gregdavill/d20-hardware/enclosure/r0.1/stl/SPECS.md

# 3d printing specs

Design printed and validated with Spapeways

Material: Multi Jet Fusion Plastic (PA12)
Colour: Black
Cost: ~$80 USD
