gregdavill/d20-hardware/docs/repository-open-graph-template.png

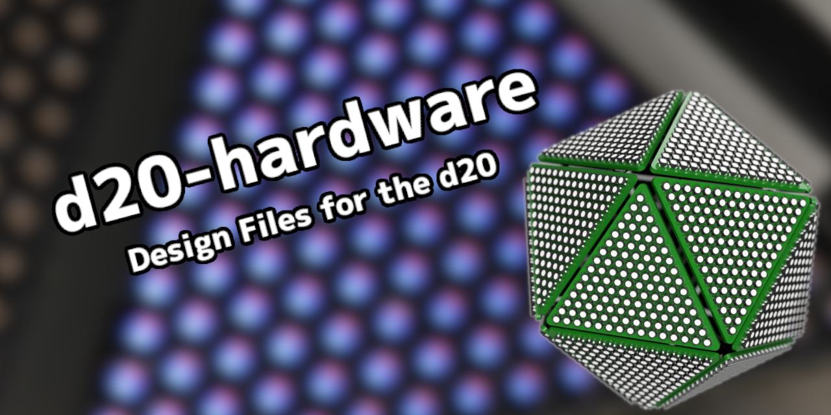
docs/repository-open-graph-template.png
