gregdavill/d20-hardware/pcb/controller/d20_r0.1/Production/d20_r0.1-Front.png

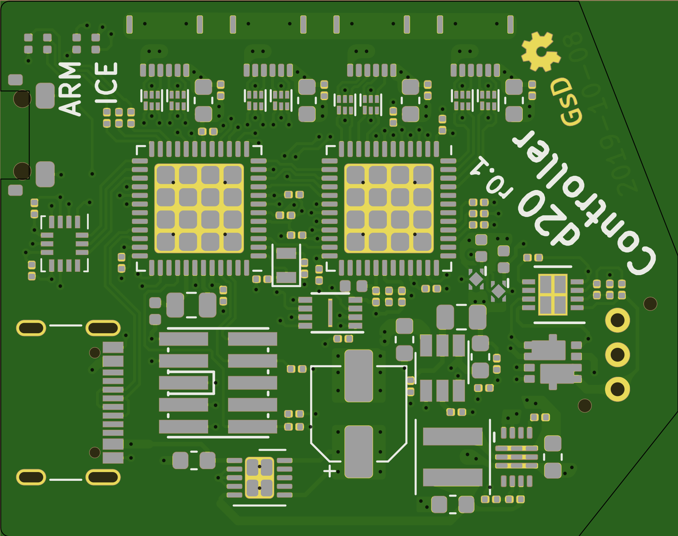
pcb/controller/d20_r0.1/Production/d20_r0.1-Front.png
