gregdavill/d20-hardware/pcb/led-panels/d20_tri_r0.1/Production/tri_4x1_r0.1-Front.png

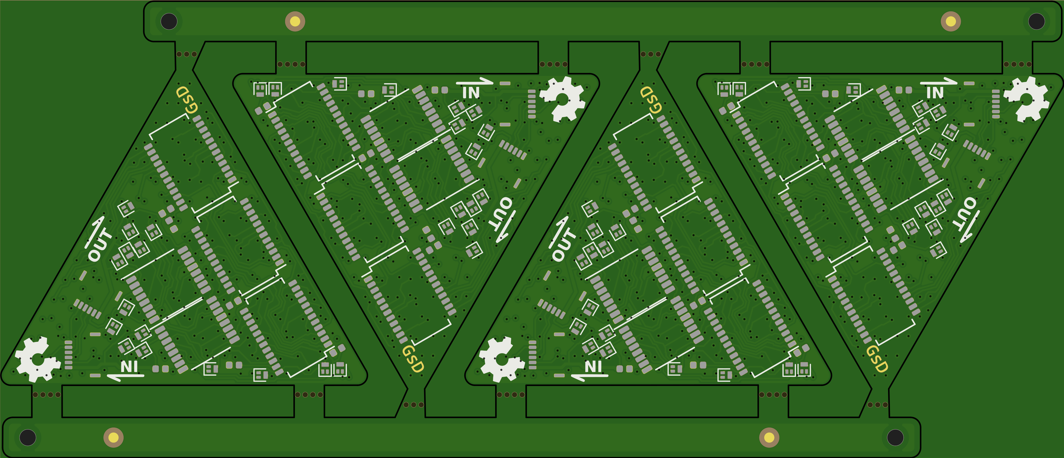
pcb/led-panels/d20_tri_r0.1/Production/tri_4x1_r0.1-Front.png
