gregdavill/d20-hardware/pcb/led-panels/d20_tri_r0.2/Production/d20_tri_r0.2_4x1-Front.png

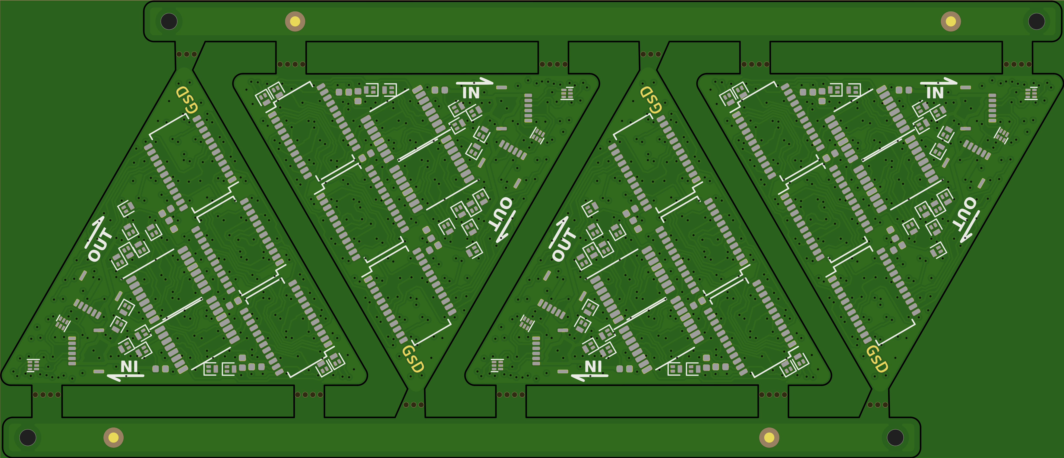
pcb/led-panels/d20_tri_r0.2/Production/d20_tri_r0.2_4x1-Front.png
