gregdavill/d20-hardware/pcb/led-panels/d20_tri_r0.2/ref/ref.png

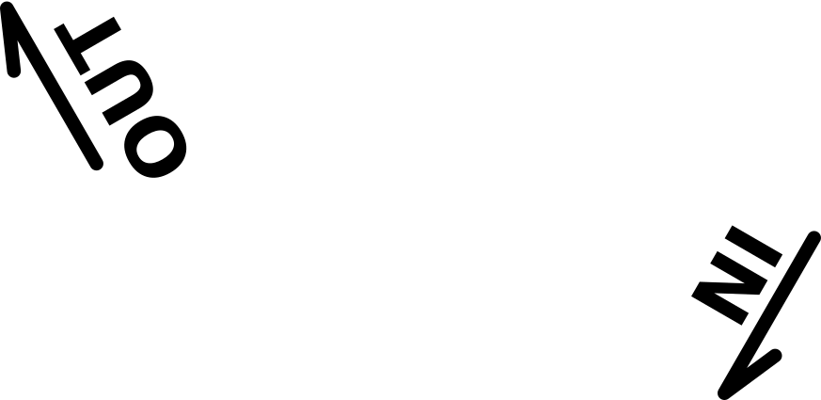
pcb/led-panels/d20_tri_r0.2/ref/ref.png
