gregdavill/d20-hardware/pcb/led-panels/d20_tri_r0.3/Production/d20_tri_r0.3_4x1-Front.png

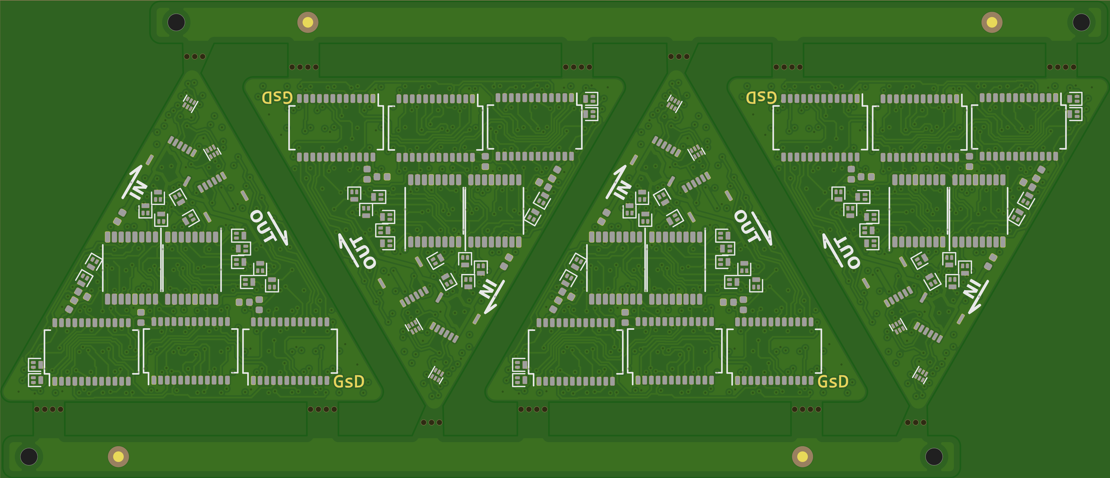
pcb/led-panels/d20_tri_r0.3/Production/d20_tri_r0.3_4x1-Front.png
