gregdavill/d20-hardware/enclosure/r0.1/d20_enclosure_r0.1.step

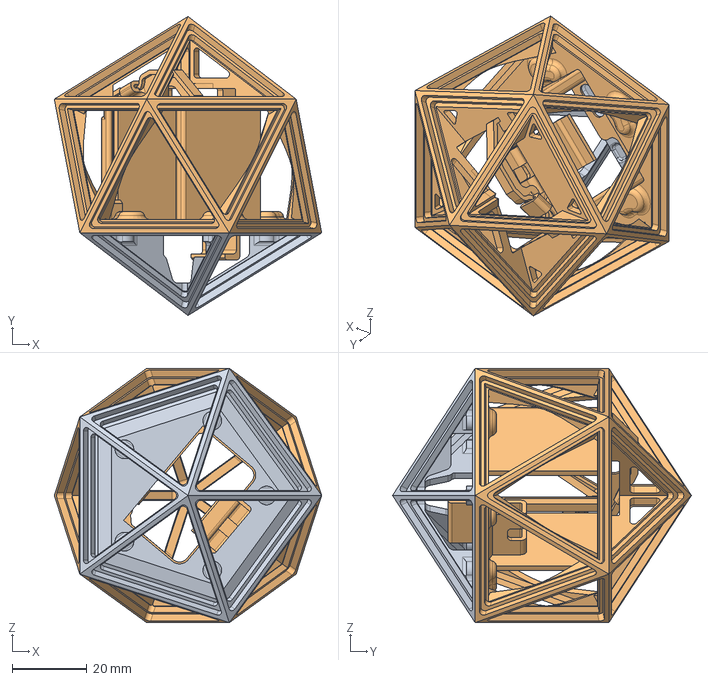
[picture p16: CAD file, 2021-06-30]
enclosure/r0.1/d20_enclosure_r0.1.step
71.5 x 79.9 x 68.0 mm
enclosure: top
enclosure: bottom
