gregdavill/d20-hardware/enclosure/r0.1/stl/d20_enclosure_r0.1_001.stl

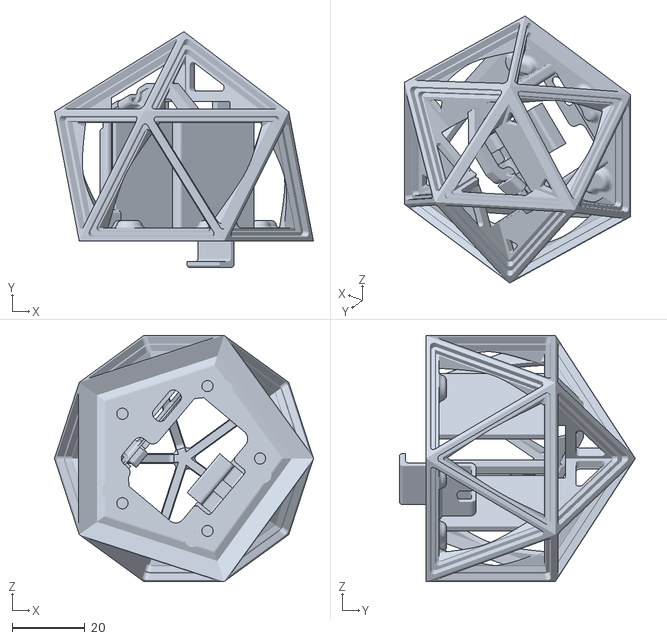
[picture p17: CAD file, 2021-03-29]
enclosure/r0.1/stl/d20_enclosure_r0.1_001.stl
71.5 x 65.0 x 68.0
