gregdavill/d20-hardware/enclosure/r0.1/stl/d20_enclosure_r0.1_002.stl

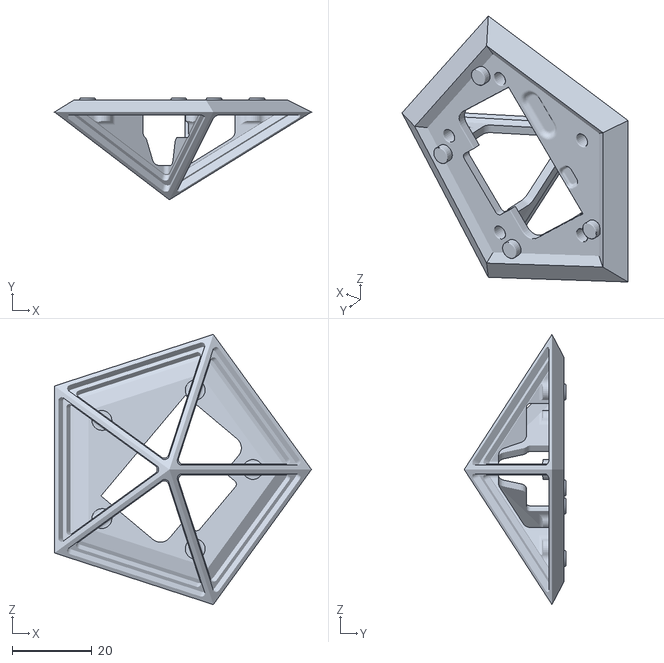
[picture p18: CAD file, 2021-03-29]
enclosure/r0.1/stl/d20_enclosure_r0.1_002.stl
64.6 x 25.6 x 68.0
