gregdavill/d20-hardware/(list of files, cad)

Other CAD files:
enclosure/r0.1/d20_enclosure_r0.1_assembly.step
enclosure/r0.1/d20_enclosure_r0.1 Assembly (No Panels).step
enclosure/r0.1/d20_enclosure_r0.1.f3d
