gregdavill/d20-hardware/(threads)

Thread 3 (2021-06-24):

Fix BOM

gregdavill, 2021-06-24:
Many of these PCBs were designed with Skidl, and the xml output format of the BOM doesn't contain orderable part numbers.

Thread 4 (2022-02-15):

Enclosure walls reported to be too thin for 3D printing

akaij, 2022-02-15:
I just tried to get the enclosures printed by JLCPCB, as I don't have a printer. I uploaded both `.stl` files and using `PA12-HP Nylon` as the material, sent them for inspection before printing and they got back to me a few hours later:

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

In hindsight, they do specify the requirements for 3D printing below the upload button:
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

Not being familiar with 3D printing (but willing to learn!), and on the off-chance someone else runs into the same issue, I wanted to ask you what steps should be taken at this point, if any.

gregdavill, 2022-02-15:
I feel like some pretty major modifications would need to be made to fulfill these requirements.

The model was designed to be printed with shapeways, which accepted the file without issue.

I also managed to print this with PCBWay's service, also using Nylon PA12.
But the tolerance on the lid was a bit off compared to shapeways, I think they angled the part differently when printing.

gregdavill, 2022-02-15:
Some more insight, out of the two parts I got from PCBWay, one had a chip along one of the edges. The print would still technically work.

This is basically what they're asking in the first place. That due to the geometry some features might break/crack. This also depends on how rough they are with their internal process and shipping conditions.

You should be able to agree, and have them still build it for you.

akaij, 2022-02-16:
Just checked Shapeways pricing for printing both and shipping them to Europe, and I think it will be worth it to take a chance and get it printed by PCBWay or JLCPCB 😂

Thank you!

gregdavill, 2022-02-16:
Totally understand! When I'd originally designed this these lower cost services didn't exist yet in their current form.

I'd be very interested to see what your experience is if you order these. I'll be writing up a review of the PCBWay prints, would be nice to include a comparison.

akaij, 2022-02-16:
I will definitely let you know when I receive them!

epac-tom, 2022-05-11:
@akay did you go ahead and order these? How did they turn out?

Closed 2022-02-16.

Thread 5 (2022-02-19):

JLCPCB controller printing issue

akaij, 2022-02-19:
I uploaded the controller zip file to PCB to be printed, and they just got back to me with this:

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

I'm not sure I understand the question, but I think they are asking whether this file has been printed before without problems, in which case I should be replying with `A`. What do you think?

I'm creating the issue in case anyone else experiences the same confusion in the future.

gregdavill, 2022-02-19:
I'm not sure exactly why JLC asks this, surely they should know if the file has been run through their DFM optimization before.

The design gerbers are straight out of KiCad, so you should typically go for option 'B'.
But I've found asking for option 'A' is also fine most of the time.

akaij, 2022-02-19:
Thank you! I responded with 'B', and will update this issue if there are any issues with the controller during assembly :)

Closed 2022-02-19.
