gregdavill/d20-hardware/pcb/led-panels/d20_tri_r1.0/kicad-src/d20_tri_r1.0.kicad_pcb

## KiCad design pcb/led-panels/d20_tri_r1.0/kicad-src/d20_tri_r1.0.kicad_pcb (2022-06-25)

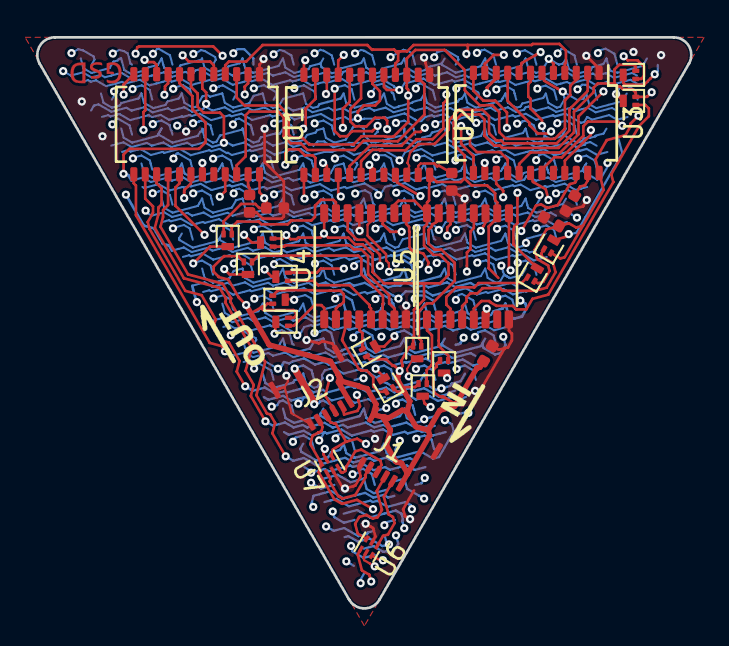
[picture p19: board d20_tri_r1.0.kicad_pcb from above]

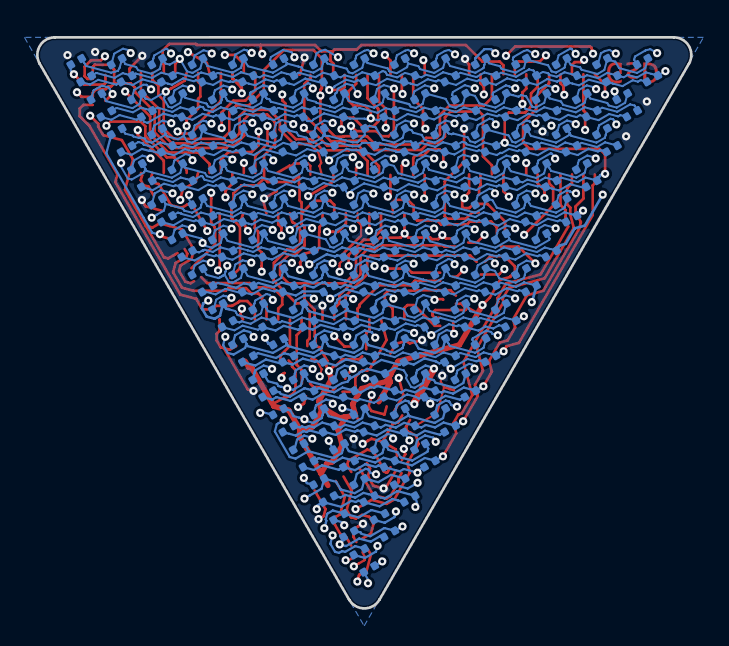
[picture p20: board d20_tri_r1.0.kicad_pcb from below]

Board: 4 copper layers, 36.3 x 31.7 mm, 150 parts (120 on the bottom side), 93 nets.

Parts:
C1, C2, C3: 470nF; C_0402_1005Metric
D1, D2, D3, D4, D5, D6, D7, D8, D9, D10, D11, D12, D13, D14, D15, D17, D18, D19, D20, D21, D22, D23, D24, D25, D26, D27, D28, D29, D30, D33, D34, D35, D36, D37, D38, D39, D40, D41, D42, D43, D44, D45, D49, D50, D51, D52, D53, D54, D55, D56, D57, D58, D59, D60, D65, D66, D67, D68, D69, D70, D71, D72, D73, D74, D75, D81, D82, D83, D84, D85, D86, D87, D88, D89, D90, D97, D98, D99, D100, D101, D102, D103, D104, D105, D113, D114, D115, D116, D117, D118, D119, D120, D129, D130, D131, D132, D133, D134, D135, D145, D146, D147, D148, D149, D150, D161, D162, D163, D164, D165, D177, D178, D179, D180, D193, D194, D195, D209, D210, D225: LED_ARGB; LED_1515_RBGA_slim
J1: input; 5034800600
J2: output; 5034800600
Q1, Q2, Q3, Q4, Q5, Q6, Q7, Q8, Q9, Q10, Q11, Q12, Q13, Q14, Q15: LP0404N3T5G; SOT-883
R1: 2.2k; R_0402_1005Metric
R2: 7.5k; R_0402_1005Metric
R3: 4.12k; R_0402_1005Metric
U1, U2, U3: TLC59025; SSOP-24_slim
U4, U5: 74HC595; TSSOP-16_slim
U6, U7: NC7WZ17; UDFN-6_1x1mm_P0.35mm

Connections:
U1_r_ext: R1.1, U1.23
U2_r_ext: R2.1, U2.23
U3_r_ext: R3.1, U3.23
blank: J2.3, U1.21, U2.21, U3.21, U6.4
blank_i: J1.3, U6.3
colb_0: D1.2, D17.2, D33.2, D49.2, D65.2, D81.2, D97.2, D113.2, D129.2, D145.2, D161.2, D177.2, D193.2, D209.2, D225.2, U3.5
colb_1: D2.2, D18.2, D34.2, D50.2, D66.2, D82.2, D98.2, D114.2, D130.2, D146.2, D162.2, D178.2, D194.2, D210.2, U3.6
colb_2: D3.2, D19.2, D35.2, D51.2, D67.2, D83.2, D99.2, D115.2, D131.2, D147.2, D163.2, D179.2, D195.2, U3.7
colb_3: D4.2, D20.2, D36.2, D52.2, D68.2, D84.2, D100.2, D116.2, D132.2, D148.2, D164.2, D180.2, U3.8
colb_4: D5.2, D21.2, D37.2, D53.2, D69.2, D85.2, D101.2, D117.2, D133.2, D149.2, D165.2, U3.9
colb_5: D6.2, D22.2, D38.2, D54.2, D70.2, D86.2, D102.2, D118.2, D134.2, D150.2, U3.10
colb_6: D7.2, D23.2, D39.2, D55.2, D71.2, D87.2, D103.2, D119.2, D135.2, U3.11
colb_7: D8.2, D24.2, D40.2, D56.2, D72.2, D88.2, D104.2, D120.2, U3.12
colb_8: D9.2, D25.2, D41.2, D57.2, D73.2, D89.2, D105.2, U3.13
colb_9: D10.2, D26.2, D42.2, D58.2, D74.2, D90.2, U3.14
colb_10: D11.2, D27.2, D43.2, D59.2, D75.2, U3.15
colb_11: D12.2, D28.2, D44.2, D60.2, U3.16
colb_12: D13.2, D29.2, D45.2, U3.17
colb_13: D14.2, D30.2, U3.18
colb_14: D15.2, U3.19
colg_0: D1.3, D17.3, D33.3, D49.3, D65.3, D81.3, D97.3, D113.3, D129.3, D145.3, D161.3, D177.3, D193.3, D209.3, D225.3, U2.5
colg_1: D2.3, D18.3, D34.3, D50.3, D66.3, D82.3, D98.3, D114.3, D130.3, D146.3, D162.3, D178.3, D194.3, D210.3, U2.6
colg_2: D3.3, D19.3, D35.3, D51.3, D67.3, D83.3, D99.3, D115.3, D131.3, D147.3, D163.3, D179.3, D195.3, U2.7
colg_3: D4.3, D20.3, D36.3, D52.3, D68.3, D84.3, D100.3, D116.3, D132.3, D148.3, D164.3, D180.3, U2.8
colg_4: D5.3, D21.3, D37.3, D53.3, D69.3, D85.3, D101.3, D117.3, D133.3, D149.3, D165.3, U2.9
colg_5: D6.3, D22.3, D38.3, D54.3, D70.3, D86.3, D102.3, D118.3, D134.3, D150.3, U2.10
colg_6: D7.3, D23.3, D39.3, D55.3, D71.3, D87.3, D103.3, D119.3, D135.3, U2.11
colg_7: D8.3, D24.3, D40.3, D56.3, D72.3, D88.3, D104.3, D120.3, U2.12
colg_8: D9.3, D25.3, D41.3, D57.3, D73.3, D89.3, D105.3, U2.13
colg_9: D10.3, D26.3, D42.3, D58.3, D74.3, D90.3, U2.14
colg_10: D11.3, D27.3, D43.3, D59.3, D75.3, U2.15
colg_11: D12.3, D28.3, D44.3, D60.3, U2.16
colg_12: D13.3, D29.3, D45.3, U2.17
colg_13: D14.3, D30.3, U2.18
colg_14: D15.3, U2.19
colr_0: D1.4, D17.4, D33.4, D49.4, D65.4, D81.4, D97.4, D113.4, D129.4, D145.4, D161.4, D177.4, D193.4, D209.4, D225.4, U1.5
colr_1: D2.4, D18.4, D34.4, D50.4, D66.4, D82.4, D98.4, D114.4, D130.4, D146.4, D162.4, D178.4, D194.4, D210.4, U1.6
colr_2: D3.4, D19.4, D35.4, D51.4, D67.4, D83.4, D99.4, D115.4, D131.4, D147.4, D163.4, D179.4, D195.4, U1.7
colr_3: D4.4, D20.4, D36.4, D52.4, D68.4, D84.4, D100.4, D116.4, D132.4, D148.4, D164.4, D180.4, U1.8
colr_4: D5.4, D21.4, D37.4, D53.4, D69.4, D85.4, D101.4, D117.4, D133.4, D149.4, D165.4, U1.9
colr_5: D6.4, D22.4, D38.4, D54.4, D70.4, D86.4, D102.4, D118.4, D134.4, D150.4, U1.10
colr_6: D7.4, D23.4, D39.4, D55.4, D71.4, D87.4, D103.4, D119.4, D135.4, U1.11
colr_7: D8.4, D24.4, D40.4, D56.4, D72.4, D88.4, D104.4, D120.4, U1.12
colr_8: D9.4, D25.4, D41.4, D57.4, D73.4, D89.4, D105.4, U1.13
colr_9: D10.4, D26.4, D42.4, D58.4, D74.4, D90.4, U1.14
colr_10: D11.4, D27.4, D43.4, D59.4, D75.4, U1.15
colr_11: D12.4, D28.4, D44.4, D60.4, U1.16
colr_12: D13.4, D29.4, D45.4, U1.17
colr_13: D14.4, D30.4, U1.18
colr_14: D15.4, U1.19
dat: U1.2, U6.6
dat_i: J1.2, U6.1
dat_out: J2.2, U5.9
gnd: C1.2, C2.2, C3.2, J1.6, J1.SH, J2.6, J2.SH, R1.2, R2.2, R3.2, U1.1, U2.1, U3.1, U4.8, U4.13, U5.8, U5.13, U6.2, U7.2
latch: J2.4, U1.4, U2.4, U3.4, U4.12, U5.12, U7.4
latch_i: J1.4, U7.3
row_0: D1.1, D2.1, D3.1, D4.1, D5.1, D6.1, D7.1, D8.1, D9.1, D10.1, D11.1, D12.1, D13.1, D14.1, D15.1, Q1.3
row_1: D17.1, D18.1, D19.1, D20.1, D21.1, D22.1, D23.1, D24.1, D25.1, D26.1, D27.1, D28.1, D29.1, D30.1, Q2.3
row_2: D33.1, D34.1, D35.1, D36.1, D37.1, D38.1, D39.1, D40.1, D41.1, D42.1, D43.1, D44.1, D45.1, Q3.3
row_3: D49.1, D50.1, D51.1, D52.1, D53.1, D54.1, D55.1, D56.1, D57.1, D58.1, D59.1, D60.1, Q4.3
row_4: D65.1, D66.1, D67.1, D68.1, D69.1, D70.1, D71.1, D72.1, D73.1, D74.1, D75.1, Q5.3
row_5: D81.1, D82.1, D83.1, D84.1, D85.1, D86.1, D87.1, D88.1, D89.1, D90.1, Q6.3
row_6: D97.1, D98.1, D99.1, D100.1, D101.1, D102.1, D103.1, D104.1, D105.1, Q7.3
row_7: D113.1, D114.1, D115.1, D116.1, D117.1, D118.1, D119.1, D120.1, Q8.3
row_8: D129.1, D130.1, D131.1, D132.1, D133.1, D134.1, D135.1, Q9.3
row_9: D145.1, D146.1, D147.1, D148.1, D149.1, D150.1, Q10.3
row_10: D161.1, D162.1, D163.1, D164.1, D165.1, Q11.3
row_11: D177.1, D178.1, D179.1, D180.1, Q12.3
row_12: D193.1, D194.1, D195.1, Q13.3
row_13: D209.1, D210.1, Q14.3
row_14: D225.1, Q15.3
sclk: J2.5, U1.3, U2.3, U3.3, U4.11, U5.11, U7.6
sclk_i: J1.5, U7.1
sdo_U1>sdi_U2: U1.22, U2.2
sdo_U2>sdi_U3: U2.22, U3.2
sdo_U3: U3.22, U4.14
sdo_U4>sdi_U5: U4.9, U5.14
srow_0: Q1.1, U4.15
srow_1: Q2.1, U4.1
srow_2: Q3.1, U4.2
srow_3: Q4.1, U4.3
srow_4: Q5.1, U4.4
srow_5: Q6.1, U4.5
srow_6: Q7.1, U4.6
srow_7: Q8.1, U4.7
srow_8: Q9.1, U5.15
srow_9: Q10.1, U5.1
srow_10: Q11.1, U5.2
srow_11: Q12.1, U5.3
srow_12: Q13.1, U5.4
srow_13: Q14.1, U5.5
srow_14: Q15.1, U5.6
vcc: C1.1, C2.1, C3.1, J1.1, J2.1, Q1.2, Q2.2, Q3.2, Q4.2, Q5.2, Q6.2, Q7.2, Q8.2, Q9.2, Q10.2, Q11.2, Q12.2, Q13.2, Q14.2, Q15.2, U1.24, U2.24, U3.24, U4.10, U4.16, U5.10, U5.16, U6.5, U7.5
