gregdavill/d20-hardware/pcb/controller/d20_r0.1/kicad-src/d20_r0.1.kicad_pcb

## KiCad design pcb/controller/d20_r0.1/kicad-src/d20_r0.1.kicad_pcb (2021-03-29)

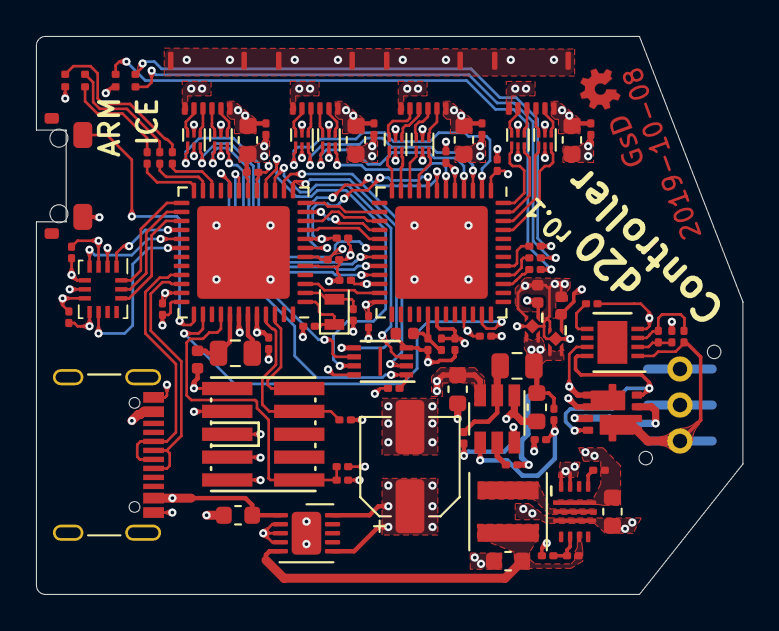
[picture p21: board d20_r0.1.kicad_pcb from above]

Board: 4 copper layers, 39.2 x 31.0 mm, 89 parts (1 on the bottom side), 96 nets.

Parts:
C1, C2, C4, C5, C24, C26, C28, C30, C35: 10uF; C_0603_1608Metric
C3, C10, C11, C12, C13, C17, C18, C19, C20, C21, C22, C23, C25, C27, C29, C31, C32, C33, C34: 100nF; C_0201_0603Metric
C6, C7, C8, C14: 1uF; C_0402_1005Metric
C9: CP1; CP_Elec_5x3.9
C15, C16: 22pF; C_0201_0603Metric
D1, D2: LED_ARGB; led_rbag_1515
FB1: Ferrite_Bead_Small; L_0201_0603Metric
J1: Conn_01x03; 3P_Battery_Connector
J2, J3, J4, J5: Conn_01x06_Shielded; 5034800600
J6: Conn_02x05_Odd_Even; FTSH-105-XX-X-DV
J7: USB_C_Receptacle_USB2.0; USB_C_Receptacle_Palconn_UTC16-G
L1: 1uH; L_Coilcraft_XxL4020
L2: 2.2uH; L_0805_2012Metric
L3: 10uH; L_0805_2012Metric
R1, R6: 510k; R_0201_0603Metric
R2: 25.3k; R_0201_0603Metric
R3: 34.8k; R_0201_0603Metric
R4: 750k; R_0201_0603Metric
R5, R8: 100k; R_0201_0603Metric
R7: 93.1k; R_0201_0603Metric
R9: 33.2k; R_0201_0603Metric
R10, R17, R19, R20: 10k; R_0201_0603Metric
R11, R12, R13, R14, R15, R16: 470R; R_0201_0603Metric
R18: 1k; R_0201_0603Metric
SW1: SW_Push; EVQP4
U1: LTC4367; DFN-8-1EP_3x3mm_P0.5mm_EP1.66x2.38mm
U2: AON7804; DFN3X3_8L_EP2_P
U3: TPS62135; VQFN-11_3x2mm_P0.5mm
U4: TPS561201; TSOT-23-6
U5: NP115-2.5; X2SON_4_1.0x1.0mm
U6: NP115-1.2; X2SON_4_1.0x1.0mm
U7: ATSAMD51G19A; QFN-48-1EP_7x7mm_P0.5mm_EP5.15x5.15mm
U8: ICE40UP5K-SG48ITR; QFN-48-1EP_7x7mm_P0.5mm_EP5.15x5.15mm
U9, U10, U11, U12, U13, U14, U15, U16: NC7WZ17; UDFN-6_1x1mm_P0.35mm
U17: BMX160; Bosch_LGA-14_3x2.5mm_P0.5mm
U18: AT25SF081; DFN-8-1EP_3x2mm_Pitch0.5mm
U19: LTC4413-2; DFN-10-1EP_3x3mm_P0.5mm_EP1.65x2.38mm
Y1: 32.768kHz; Crystal_SMD_2012-2Pin_2.0x1.2mm

Connections:
1v2: C7.1, C22.1, C23.1, FB1.1, U6.1, U8.5, U8.30
1v2_pll: C8.1, C21.1, FB1.2, U8.29
2v5: C6.1, C20.1, U5.1, U8.24
3v3: C5.1, C10.1, C11.1, C12.1, C13.1, C17.1, C18.1, C19.1, C33.1, C34.1, D1.1, D2.1, L2.2, R9.2, R18.2, R19.2, R20.2, U5.3, U5.4, U6.3, U6.4, U7.6, U7.17, U7.36, U7.44, U8.1, U8.22, U8.33, U17.5, U17.8, U18.8
3v3_fb: R9.1, R10.1, U4.4
4v5: C9.1, C24.1, C25.1, C26.1, C27.1, C28.1, C29.1, C30.1, C31.1, J2.1, J3.1, J4.1, J5.1, U9.5, U10.5, U11.5, U12.5, U13.5, U14.5, U15.5, U16.5, U19.6, U19.10
4v5_in: C2.1, L1.2, R6.2, U3.6, U19.5
5v0_usb: C35.1, J7.A4, J7.A9, J7.B4, J7.B9, U19.1
5v_fb: R6.1, R7.1, U3.5
unnamed: U2.2, U2.5
unnamed: U1.8, U2.3, U2.6
unnamed: R1.1, U1.5
unnamed: R3.1, R4.2, U1.3
unnamed: R2.1, R3.2, U1.2
unnamed: R5.1, U3.8
unnamed: L1.1, U3.2
unnamed: R8.1, U4.5
unnamed: C3.1, U4.6
unnamed: C3.2, L2.1, U4.2
unnamed: C14.1, L3.2, U7.41
unnamed: R11.1, U7.22
unnamed: R12.1, U7.24
unnamed: R13.1, U7.23
unnamed: C15.1, U7.1, Y1.1
unnamed: C16.1, U7.2, Y1.2
unnamed: R14.1, U8.39
unnamed: R15.1, U8.40
unnamed: R16.1, U8.41
unnamed: U7.38, U8.35
unnamed: U7.3, U8.23
unnamed: SW1.1, U7.37
unnamed: L3.1, U7.43
_led0_blank: U8.20, U9.1
_led0_data: U8.21, U9.3
_led0_latch: U8.19, U10.3
_led0_sclk: U8.18, U10.1
_led1_blank: U8.4, U11.1
_led1_data: U8.6, U11.3
_led1_latch: U8.3, U12.3
_led1_sclk: U8.2, U12.1
_led2_blank: U8.10, U13.1
_led2_data: U8.9, U13.3
_led2_latch: U8.11, U14.3
_led2_sclk: U8.12, U14.1
_led3_blank: U8.46, U15.1
_led3_data: U8.45, U15.3
_led3_latch: U8.47, U16.3
_led3_sclk: U8.48, U16.1
gnd: C1.2, C2.2, C4.2, C5.2, C6.2, C7.2, C8.2, C9.2, C10.2, C11.2, C12.2, C13.2, C14.2, C15.2, C16.2, C17.2, C18.2, C19.2, C20.2, C21.2, C22.2, C23.2, C24.2, C25.2, C26.2, C27.2, C28.2, C29.2, C30.2, C31.2, C32.2, C33.2, C34.2, C35.2, J1.3, J2.6, J2.SH, J3.6, J3.SH, J4.6, J4.SH, J5.6, J5.SH, J6.1, J6.3, J6.5, J6.7, J6.9, J7.A1, J7.A12, J7.B1, J7.B12, J7.S1, R1.2, R2.2, R7.2, R10.2, R17.2, SW1.2, U1.4, U3.3, U3.10, U3.11, U4.1, U5.2, U6.2, U7.5, U7.18, U7.35, U7.42, U7.49, U8.49, U9.2, U10.2, U11.2, U12.2, U13.2, U14.2, U15.2, U16.2, U17.2, U17.3, U17.6, U17.7, U18.4, U19.2, U19.3, U19.4, U19.11
ice_config_done: U7.7, U8.7
ice_config_miso: U7.12, U8.14
ice_config_mosi: U7.9, U8.17
ice_config_reset: R17.1, U7.8, U8.8
ice_config_sck: U7.10, U8.15
ice_config_ss: U7.11, U8.16
ice_led_b: D2.4, R16.2
ice_led_g: D2.3, R15.2
ice_led_r: D2.2, R14.2
imu_cs: U7.27, U17.12
imu_int1: U7.29, U17.4
imu_int2: U7.30, U17.9
imu_miso: U7.28, U17.1
imu_mosi: U7.25, U17.14
imu_sck: U7.26, U17.13
led0_blank: J2.3, U9.6
led0_data: J2.2, U9.4
led0_latch: J2.4, U10.4
led0_sclk: J2.5, U10.6
led1_blank: J3.3, U11.6
led1_data: J3.2, U11.4
led1_latch: J3.4, U12.4
led1_sclk: J3.5, U12.6
led2_blank: J4.3, U13.6
led2_data: J4.2, U13.4
led2_latch: J4.4, U14.4
led2_sclk: J4.5, U14.6
led3_blank: J5.3, U15.6
led3_data: J5.2, U15.4
led3_latch: J5.4, U16.4
led3_sclk: J5.5, U16.6
led_b: D1.4, R13.2
led_g: D1.3, R12.2
led_r: D1.2, R11.2
pp_batt: J1.1, R4.1, U1.1, U2.4
pp_batt_prot: C1.1, C4.1, R5.2, R8.2, U1.7, U2.1, U3.1, U4.3
qspi_bus_cs: R20.1, U7.20, U18.1
qspi_bus_io0: U7.13, U18.5
qspi_bus_io1: U7.14, U18.2
qspi_bus_io2: U7.15, U18.3
qspi_bus_io3: U7.16, U18.7
qspi_bus_sck: U7.19, U18.6
samd_rst: C32.1, J6.10, R19.1, U7.40
samd_usb_n: J7.A7, J7.B7, U7.33
samd_usb_p: J7.A6, J7.B6, U7.34
swdclk: J6.4, R18.1, U7.45
swdio: J6.2, U7.46
