gregdavill/d20-hardware/(commit log)

2021-03-29 Add initial design files
    [d20_enclosure_r0.1_001.stl, d20_enclosure_r0.1_002.stl, d20_r0.1.kicad_pcb, d20_r0.1_panel.kicad_pcb, d20_tri_r0.2.kicad_pcb, d20_tri_r0.3.kicad_pcb, tri_panel_4up_r0.1.kicad_pcb]
2021-05-08 Add new STEP/f3d models
    [d20_enclosure_r0.1 Assembly (No Panels).step, d20_enclosure_r0.1.f3d, d20_enclosure_r0.1.step, d20_enclosure_r0.1_assembly.step]
2021-06-30 git move lfs to git
    [d20_enclosure_r0.1.f3d, d20_enclosure_r0.1.step]
2022-06-24 pcb: Add inital r1.0 panel design
    [d20_tri_r1.0.kicad_pcb]
2022-06-24 Add basic BOM output script
2022-06-25 pcb: Update skidl script
2022-06-25 pcb: Update design
    - Add Libs
    - Fix ERC errors
    - Update config
2022-06-25 pcb: Update script
2022-06-25 pcb: Update layout
    [d20_tri_r1.0.kicad_pcb]
